UBC-Rocket/2022-2023-Avionics-HW/Radio Board/board.png

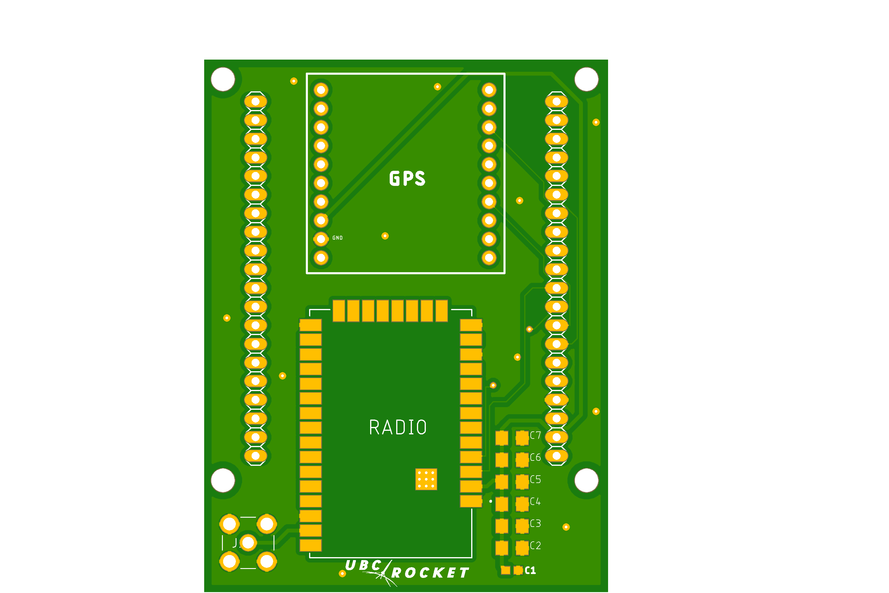
Radio Board/board.png
