UBC-Rocket/2022-2023-Avionics-HW/Ignition/Project Outputs for Avionics_Ignition/Avionics_Ignition.xlsx

Sheet: Manufacturing
 |  | Bill of Materials for |  | Avionics_Ignition.PrjPcb
 |  | Source Data From: | Avionics_Ignition.PrjPcb
 |  | Variant: | None
 |  | Report Date: | 2022-12-14 1:29 AM
 |  |  |  | Primary |  |  |  |  | Secondary
Altium Vault P/N | Designator | Description | Qty | Supplier | Supplier Part Number | Manufacturer | Manufacturer Part Number | Supplier Unit Price | Supplier | Supplier Part Number | Manufacturer | Manufacturer Part Number | Supplier Unit Price
IS2801-4 | J1, J2 | Optocoupler DC-IN 4-CH Transistor DC-OUT 16-Pin T/R | 2 | Digi-Key | IS2801-4CT-ND | Isocom | IS2801-4 | 2.2100
CMP-2000-05299-1 | J3, J4, J5 | Male Header, Pitch 2.54 mm, 1 x 2 Position, Height 9 mm, Tail Length 3.5 mm | 3 | Digi-Key | 277-1273-ND | Phoenix Contact | 1725656 | 2.7100 | Mouser | 651-1725656 | Phoenix Contact | 1725656 | 2.6300
PINHD-1X20 | JP1, JP2 | PIN HEADER | 2
WIRE_CONNECTOR | PTH1, PTH2 |  | 2
PSMN5R6-60YLX | Q1, Q2, Q3 | PSMN5R6-60YL - N-channel 60 V, 5.6 mO logic level MOSFET in LFPAK56 | 3 | Mouser | 771-PSMN5R6-60YLX | Nexperia | PSMN5R6-60YLX | 1.6300
WR06X331JTL | R1, R2, R3 | Res Thick Film 0603 330 Ohm 5% 0.1W(1/10W) ±100ppm/C SMD T/R | 3 | Digi-Key | 1292-WR06X331JTLCT-ND | Walsin Technologies | WR06X331JTL | 0.1354
CMP-1013-00510-2 | R4, R5, R9, R10, R13, R16 |  | 6 | Digi-Key | 311-1.00KCRCT-ND | Yageo | RC0805FR-071KL | 0.1354 | Digi-Key | 311-1.00KCRDKR-ND | Yageo | RC0805FR-071KL | 0.1354
CMP-1013-00102-1 | R6, R7, R8, R12, R15, R18 | 15K 0.125W 5% 0805 (2012 Metric) SMD | 6 |  |  | Rohm | MCR10EZPJ153 |  | Digi-Key | 118-CR0805-JW-153ELFCT-ND | Bourns | CR0805-JW-153ELF | 0.1354
CMP-2001-01389-1 | R11, R14, R17 |  | 3 | Digi-Key | 311-51KARCT-ND | Yageo | RC0805JR-0751KL | 0.1354 | Digi-Key | 311-51KARDKR-ND | Yageo | RC0805JR-0751KL | 0.1354

Sheet: Project Information
Project Full Path | C:\Users\trist\Desktop\Desktop\UBCEngineering\EngPhys\UBC Rocket\Avionics\2022-Avionics\Ignition\Avionics_Ignition.PrjPcb
Project Filename | Avionics_Ignition.PrjPcb
Variant Name | None
Data-Source Filename | Avionics_Ignition.PrjPcb
Data-Source Full Path | C:\Users\trist\Desktop\Desktop\UBCEngineering\EngPhys\UBC Rocket\Avionics\2022-Avionics\Ignition\Avionics_Ignition.PrjPcb
Title | Bill of Materials for Project [Avionics_Ignition.PrjPcb] (No PCB Document Selected)
Total Quantity | 30
Report Time | 1:29 AM
Report Date | 2022-12-14
Report Date & Tine | 2022-12-14 1:29 AM
Output Name | Bill of Materials
Output Type | BomReport
Output Generator Name | BOM
Output Generator Description | Bill of Materials
