UBC-Rocket/2022-2023-Avionics-HW/(list of files, drawings)

Other design files:
Ignition/Avionics_Ignition.PrjPcb
Ignition/Avionics_lib.PcbLib
Ignition/Avionics_lib.SchLib
Ignition/ignition.PcbDoc
Ignition/IgnitionPCB2.PcbDoc
Ignition/IgnitionSchem2.SchDoc
Ignition/IgnitionSchem.SchDoc
Ignition/PcbLib1.PcbLib
Ignition/schematic.PrjPcb
NewMCU/MCU.SchDoc
NewMCU/MCU_Footprints.PcbLib
NewMCU/MCU_Symbols.SchLib
NewMCU/microSD.SchDoc
NewMCU/NewMCU.PrjPcb
NewMCU/schematic.PcbDoc
NewMCU/schematic.SchDoc
