UBC-Rocket/2022-2023-Avionics-HW/Backup MCU/schematic.brd

## EAGLE design Backup MCU/schematic.brd (2023-04-22)

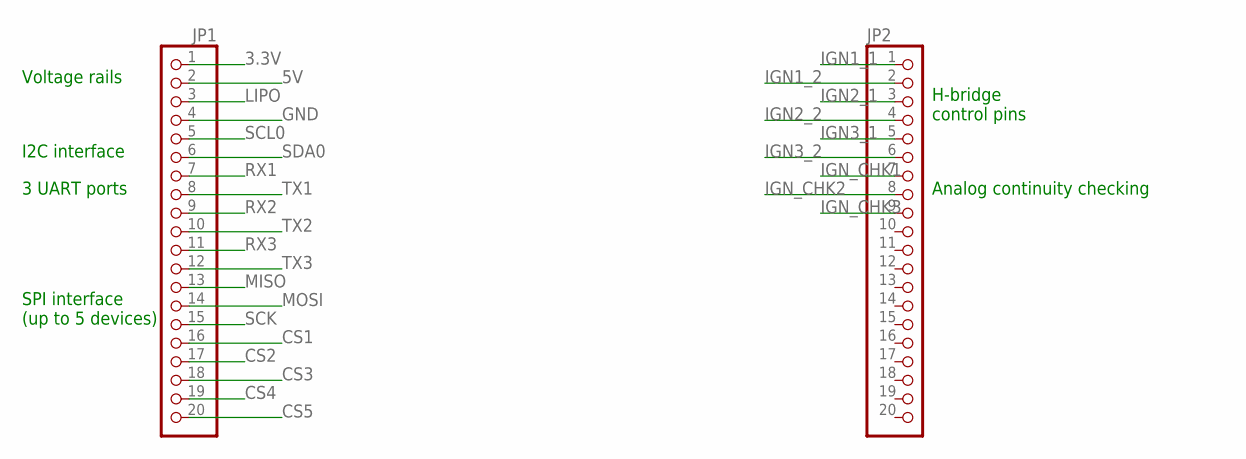
[picture p2: schematic schematic.sch, sheet 1]

Parts:
JP1, JP2: PINHD-1X20; 1X20

Connections:
3.3V: JP1.1; also elsewhere on the board
5V: JP1.2
CS1: JP1.16
CS2: JP1.17
CS3: JP1.18
CS4: JP1.19
CS5: JP1.20
GND: JP1.4; also elsewhere on the board
IGN1_1: JP2.1; also elsewhere on the board
IGN1_2: JP2.2; also elsewhere on the board
IGN2_1: JP2.3; also elsewhere on the board
IGN2_2: JP2.4; also elsewhere on the board
IGN3_1: JP2.5; also elsewhere on the board
IGN3_2: JP2.6; also elsewhere on the board
IGN_CHK1: JP2.7; also elsewhere on the board
IGN_CHK2: JP2.8; also elsewhere on the board
IGN_CHK3: JP2.9; also elsewhere on the board
LIPO: JP1.3; also elsewhere on the board
MISO: JP1.13
MOSI: JP1.14
RX1: JP1.7; also elsewhere on the board
RX2: JP1.9; also elsewhere on the board
RX3: JP1.11
SCK: JP1.15
SCL0: JP1.5; also elsewhere on the board
SDA0: JP1.6; also elsewhere on the board
TX1: JP1.8; also elsewhere on the board
TX2: JP1.10; also elsewhere on the board
TX3: JP1.12

Notes on the sheet:
SPI interface (up to 5 devices)
3 UART ports
I2C interface
Voltage rails
H-bridge control pins
Analog continuity checking

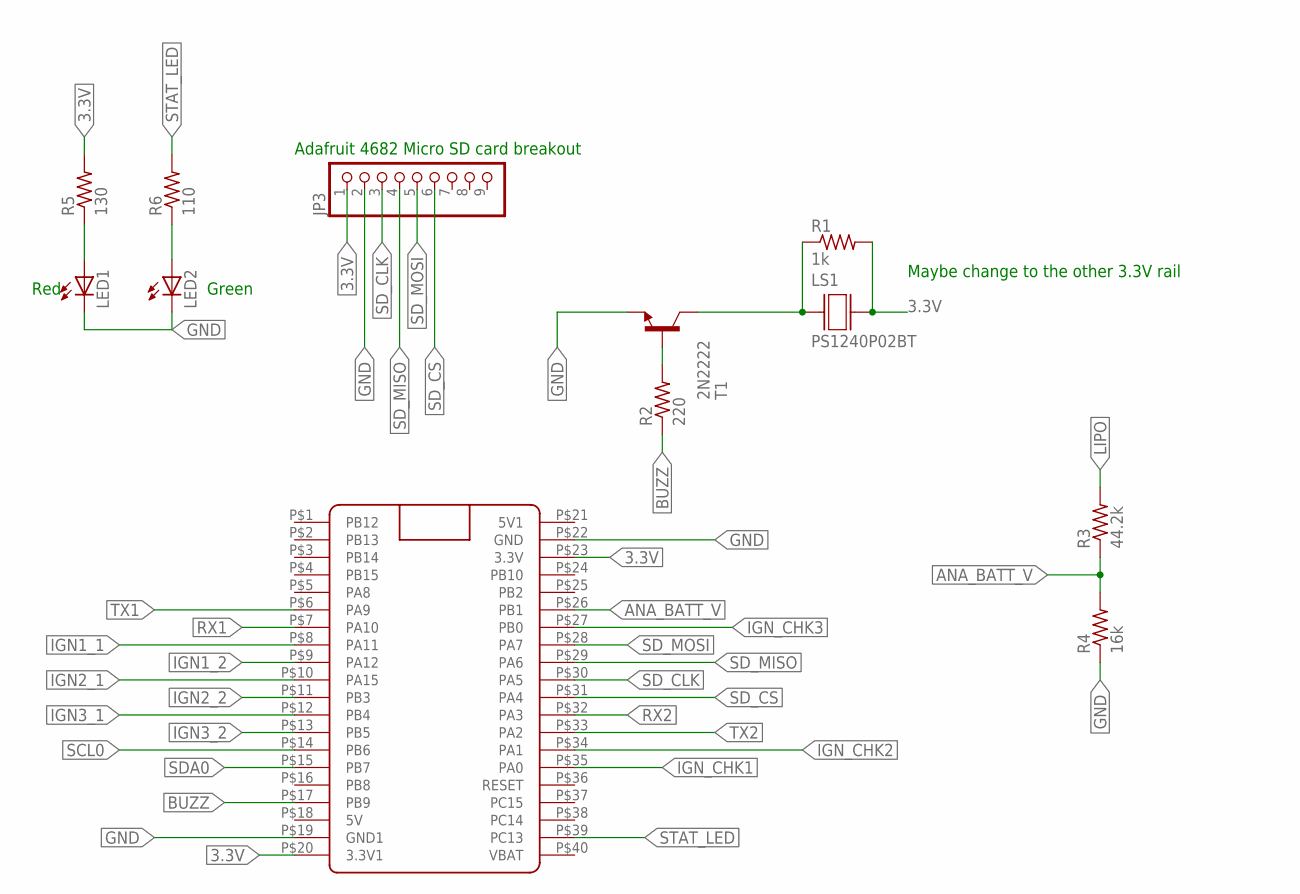
[picture p3: schematic schematic.sch, sheet 2]

Parts:
JP3: PINHD-1X9; 1X09-BIG
LED1, LED2: LED5MM
LS1: PS1240P02BT; XDCR_PS1240P02BT
R1: 1k; 0204/7
R2: 220; 0204/7
R3: 44.2k; 0204/7
R4: 16k; 0204/7
R5: 130; 0204/7
R6: 110; 0204/7
T1: 2N2222; TO92-EBC-OVAL
U$1: BLACK_PILL

Connections:
3.3V: JP3.1, LS1.2, R1.2, R5.2, U$1.P$20 (3.3V1), U$1.P$23 (3.3V); also elsewhere on the board
ANA_BATT_V: R3.1, R4.2, U$1.P$26 (PB1)
BUZZ: R2.1, U$1.P$17 (PB9)
GND: JP3.2, LED1.K (C), LED2.K (C), R4.1, T1.E, U$1.P$19 (GND1), U$1.P$22 (GND); also elsewhere on the board
IGN1_1: U$1.P$8 (PA11); also elsewhere on the board
IGN1_2: U$1.P$9 (PA12); also elsewhere on the board
IGN2_1: U$1.P$10 (PA15); also elsewhere on the board
IGN2_2: U$1.P$11 (PB3); also elsewhere on the board
IGN3_1: U$1.P$12 (PB4); also elsewhere on the board
IGN3_2: U$1.P$13 (PB5); also elsewhere on the board
IGN_CHK1: U$1.P$35 (PA0); also elsewhere on the board
IGN_CHK2: U$1.P$34 (PA1); also elsewhere on the board
IGN_CHK3: U$1.P$27 (PB0); also elsewhere on the board
LIPO: R3.2; also elsewhere on the board
unnamed: LS1.1, R1.1, T1.C
unnamed: LED1.A, R5.1
unnamed: R2.2, T1.B
unnamed: LED2.A, R6.1
RX1: U$1.P$7 (PA10); also elsewhere on the board
RX2: U$1.P$32 (PA3); also elsewhere on the board
SCL0: U$1.P$14 (PB6); also elsewhere on the board
SDA0: U$1.P$15 (PB7); also elsewhere on the board
SD_CLK: JP3.3, U$1.P$30 (PA5)
SD_CS: JP3.6, U$1.P$31 (PA4)
SD_MISO: JP3.4, U$1.P$29 (PA6)
SD_MOSI: JP3.5, U$1.P$28 (PA7)
STAT_LED: R6.2, U$1.P$39 (PC13)
TX1: U$1.P$6 (PA9); also elsewhere on the board
TX2: U$1.P$33 (PA2); also elsewhere on the board

Notes on the sheet:
Adafruit 4682 Micro SD card breakout
Maybe change to the other 3.3V rail
Green
Red

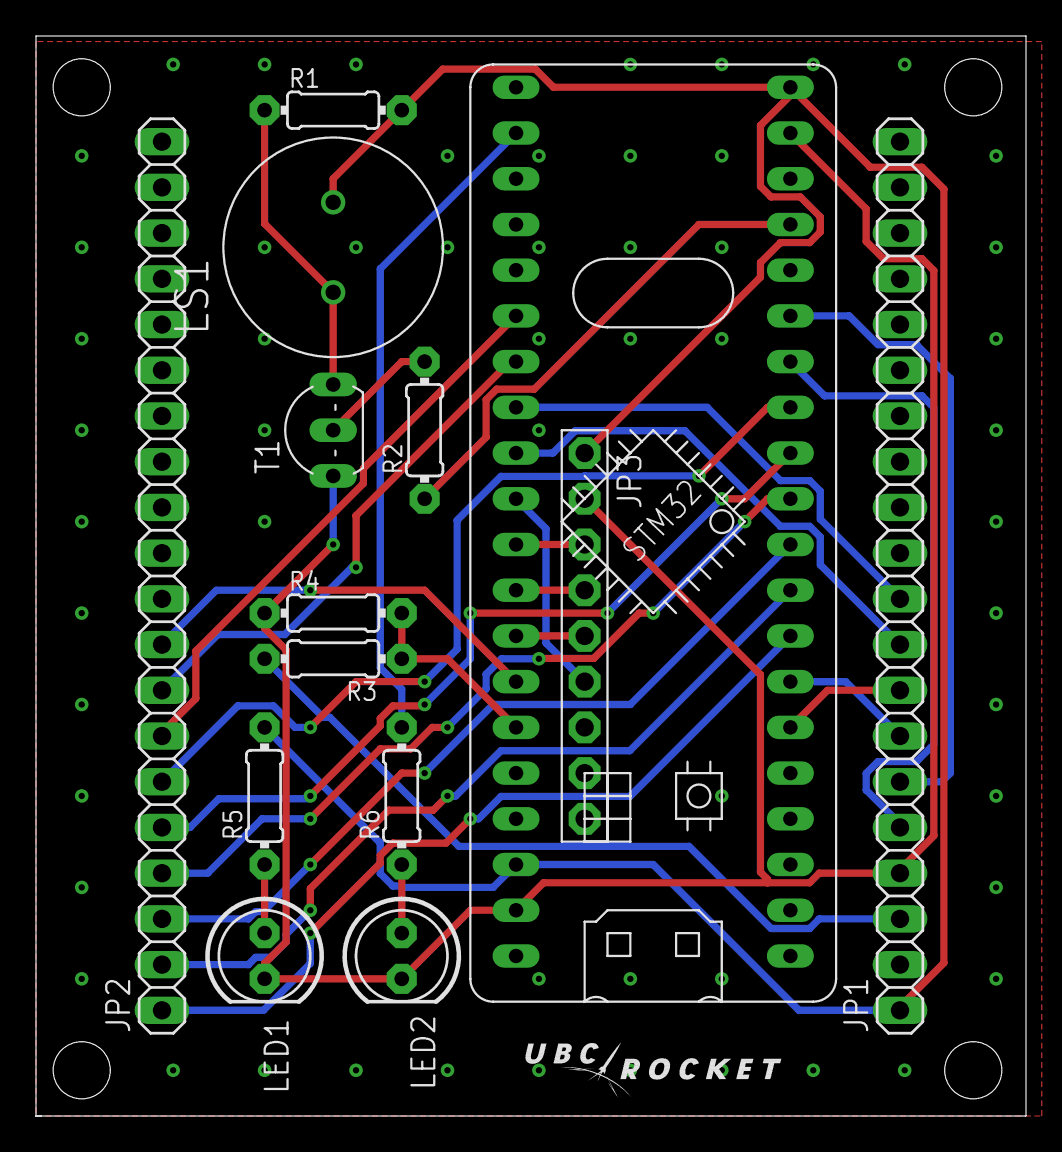
[picture p4: board Backup MCU/schematic.brd from above]

Board: 2 copper layers, 55.0 x 60.0 mm, 14 parts (0 on the bottom side), 29 nets.
