UBC-Rocket/2022-2023-Avionics-HW/STM32L433 MCU board/schematic.brd

## EAGLE design STM32L433 MCU board/schematic.brd (2023-03-19, an earlier design)

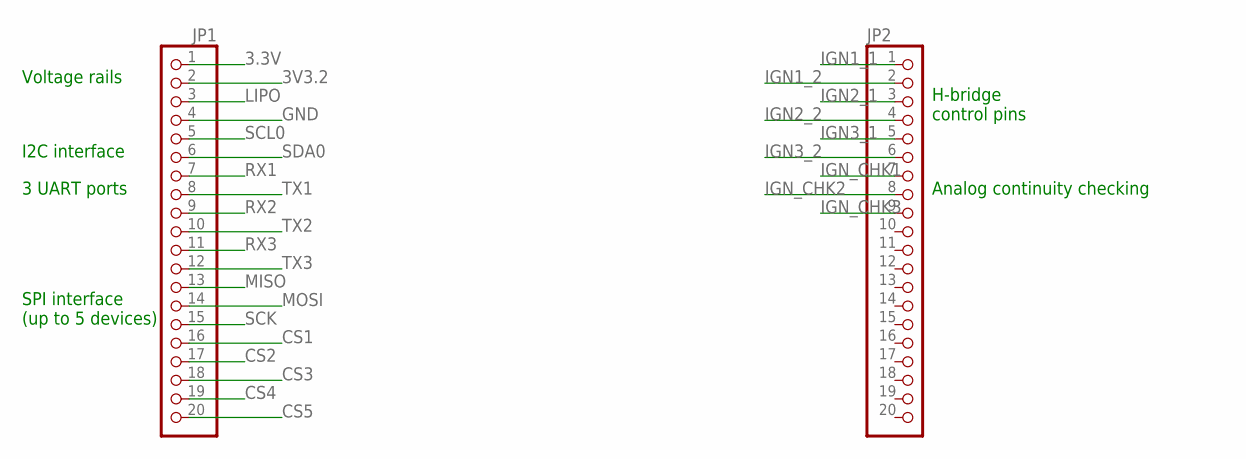
[picture p5: schematic schematic.sch, sheet 1]

Parts:
JP1, JP2: PINHD-1X20; 1X20

Connections:
3.3V: JP1.1; also elsewhere on the board
3V3.2: JP1.2
CS1: JP1.16; also elsewhere on the board
CS2: JP1.17; also elsewhere on the board
CS3: JP1.18; also elsewhere on the board
CS4: JP1.19; also elsewhere on the board
CS5: JP1.20; also elsewhere on the board
GND: JP1.4; also elsewhere on the board
IGN1_1: JP2.1; also elsewhere on the board
IGN1_2: JP2.2; also elsewhere on the board
IGN2_1: JP2.3; also elsewhere on the board
IGN2_2: JP2.4; also elsewhere on the board
IGN3_1: JP2.5; also elsewhere on the board
IGN3_2: JP2.6; also elsewhere on the board
IGN_CHK1: JP2.7; also elsewhere on the board
IGN_CHK2: JP2.8; also elsewhere on the board
IGN_CHK3: JP2.9; also elsewhere on the board
LIPO: JP1.3; also elsewhere on the board
MISO: JP1.13; also elsewhere on the board
MOSI: JP1.14; also elsewhere on the board
RX1: JP1.7; also elsewhere on the board
RX2: JP1.9; also elsewhere on the board
RX3: JP1.11; also elsewhere on the board
SCK: JP1.15; also elsewhere on the board
SCL0: JP1.5; also elsewhere on the board
SDA0: JP1.6; also elsewhere on the board
TX1: JP1.8; also elsewhere on the board
TX2: JP1.10; also elsewhere on the board
TX3: JP1.12; also elsewhere on the board

Notes on the sheet:
SPI interface (up to 5 devices)
3 UART ports
I2C interface
Voltage rails
H-bridge control pins
Analog continuity checking

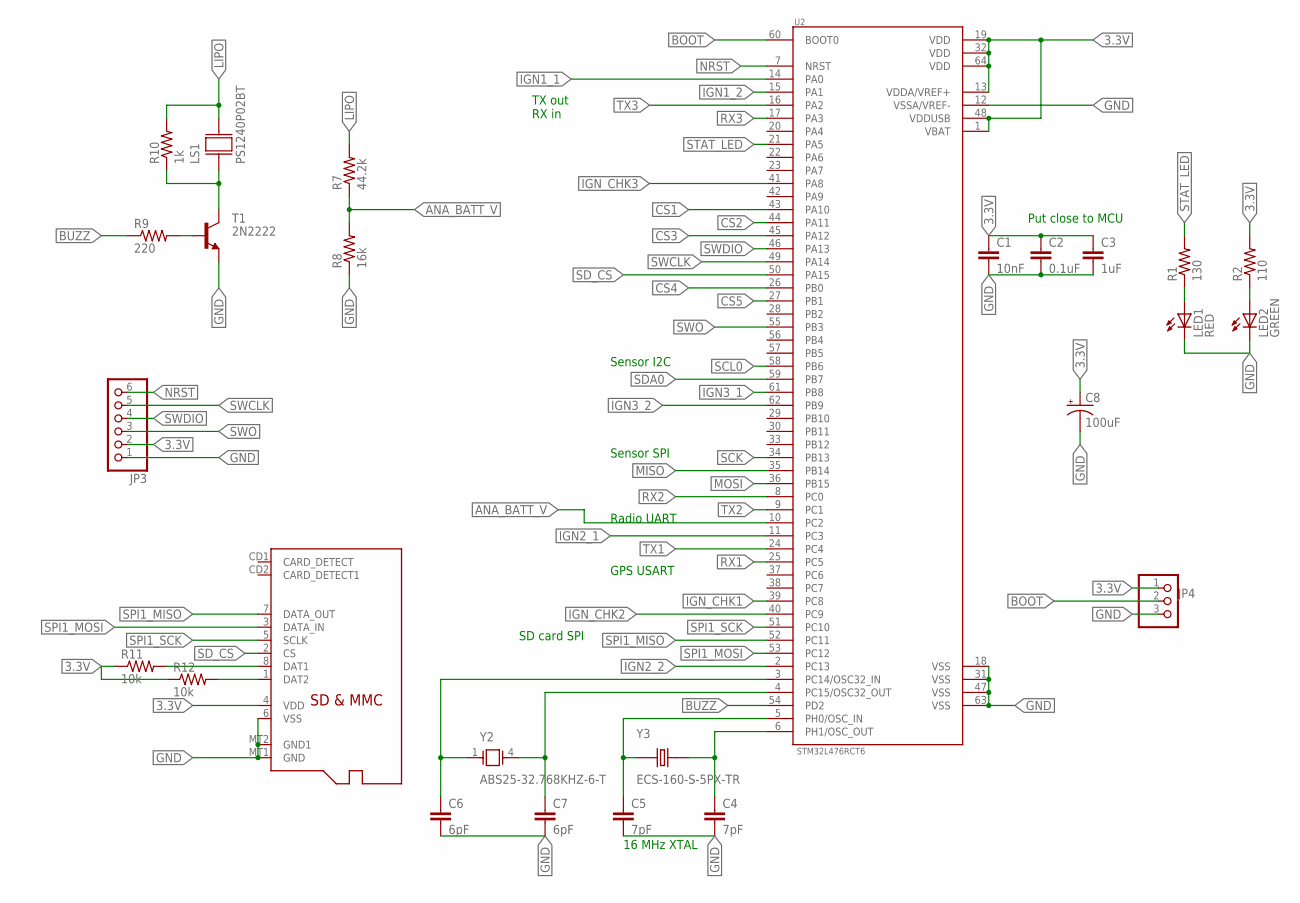
[picture p6: schematic schematic.sch, sheet 2]

Parts:
C1: 10nF; C0805
C2: 0.1uF; C0805
C3: 1uF; C0805
C4, C5: 7pF; C0805
C6, C7: 6pF; C0805
C8: 100uF; B45181B
JP3: PINHD-1X6; 1X06
JP4: PINHD-1X3; 1X03
LED1: RED; CHIPLED_0805
LED2: GREEN; CHIPLED_0805
LS1: PS1240P02BT; XDCR_PS1240P02BT
R1: 130; R0805
R2: 110; R0805
R7: 44.2k; R0805
R8: 16k; R0805
R9: 220; R0805
R10: 1k; R0805
R11, R12: 10k; R0805
T1: 2N2222; TO92-EBC-OVAL
U2: STM32L476RCT6; QFP50P120X120X160-64N
U$1: MICROSD
Y2: ABS25-32.768KHZ-6-T; XTAL_ABS25-32.768KHZ-6-T
Y3: ECS-160-S-5PX-TR; XTAL_ECS-160-S-5PX-TR

Connections:
3.3V: C1.1, C2.1, C3.1, C8.+, JP3.2, JP4.1, R2.2, R11.1, R12.1, U2.1 (VBAT), U2.13 (VDDA/VREF+), U2.19 (VDD), U2.32 (VDD), U2.48 (VDDUSB), U2.64 (VDD), U$1.4 (VDD); also elsewhere on the board
ANA_BATT_V: R7.1, R8.2, U2.10 (PC2)
BOOT: JP4.2, U2.60 (BOOT0)
BUZZ: R9.1, U2.54 (PD2)
CS1: U2.43 (PA10); also elsewhere on the board
CS2: U2.44 (PA11); also elsewhere on the board
CS3: U2.45 (PA12); also elsewhere on the board
CS4: U2.26 (PB0); also elsewhere on the board
CS5: U2.27 (PB1); also elsewhere on the board
GND: C1.2, C2.2, C3.2, C4.2, C5.2, C6.2, C7.2, C8.-, JP3.1, JP4.3, LED1.C, LED2.C, R8.1, T1.E, U2.12 (VSSA/VREF-), U2.18 (VSS), U2.31 (VSS), U2.47 (VSS), U2.63 (VSS), U$1.6 (VSS), U$1.MT1 (GND), U$1.MT2 (GND1); also elsewhere on the board
IGN1_1: U2.14 (PA0); also elsewhere on the board
IGN1_2: U2.15 (PA1); also elsewhere on the board
IGN2_1: U2.11 (PC3); also elsewhere on the board
IGN2_2: U2.2 (PC13); also elsewhere on the board
IGN3_1: U2.61 (PB8); also elsewhere on the board
IGN3_2: U2.62 (PB9); also elsewhere on the board
IGN_CHK1: U2.39 (PC8); also elsewhere on the board
IGN_CHK2: U2.40 (PC9); also elsewhere on the board
IGN_CHK3: U2.41 (PA8); also elsewhere on the board
LIPO: LS1.2, R7.2, R10.2; also elsewhere on the board
MISO: U2.35 (PB14); also elsewhere on the board
MOSI: U2.36 (PB15); also elsewhere on the board
unnamed: C5.1, U2.5 (PH0/OSC_IN), Y3.1
unnamed: R9.2, T1.B
unnamed: LS1.1, R10.1, T1.C
unnamed: R11.2, U$1.8 (DAT1)
unnamed: C4.1, U2.6 (PH1/OSC_OUT), Y3.2
unnamed: R12.2, U$1.1 (DAT2)
unnamed: LED1.A, R1.1
unnamed: LED2.A, R2.1
unnamed: C7.1, U2.4 (PC15/OSC32_OUT), Y2.4
unnamed: C6.1, U2.3 (PC14/OSC32_IN), Y2.1
NRST: JP3.6, U2.7 (NRST)
RX1: U2.25 (PC5); also elsewhere on the board
RX2: U2.8 (PC0); also elsewhere on the board
RX3: U2.17 (PA3); also elsewhere on the board
SCK: U2.34 (PB13); also elsewhere on the board
SCL0: U2.58 (PB6); also elsewhere on the board
SDA0: U2.59 (PB7); also elsewhere on the board
SD_CS: U2.50 (PA15), U$1.2 (CS)
SPI1_MISO: U2.52 (PC11), U$1.7 (DATA_OUT)
SPI1_MOSI: U2.53 (PC12), U$1.3 (DATA_IN)
SPI1_SCK: U2.51 (PC10), U$1.5 (SCLK)
STAT_LED: R1.2, U2.21 (PA5)
SWCLK: JP3.5, U2.49 (PA14)
SWDIO: JP3.4, U2.46 (PA13)
SWO: JP3.3, U2.55 (PB3)
TX1: U2.24 (PC4); also elsewhere on the board
TX2: U2.9 (PC1); also elsewhere on the board
TX3: U2.16 (PA2); also elsewhere on the board

Notes on the sheet:
Sensor SPI
Sensor I2C
SD card SPI
Put close to MCU
Radio UART
GPS USART
TX out RX in
16 MHz XTAL

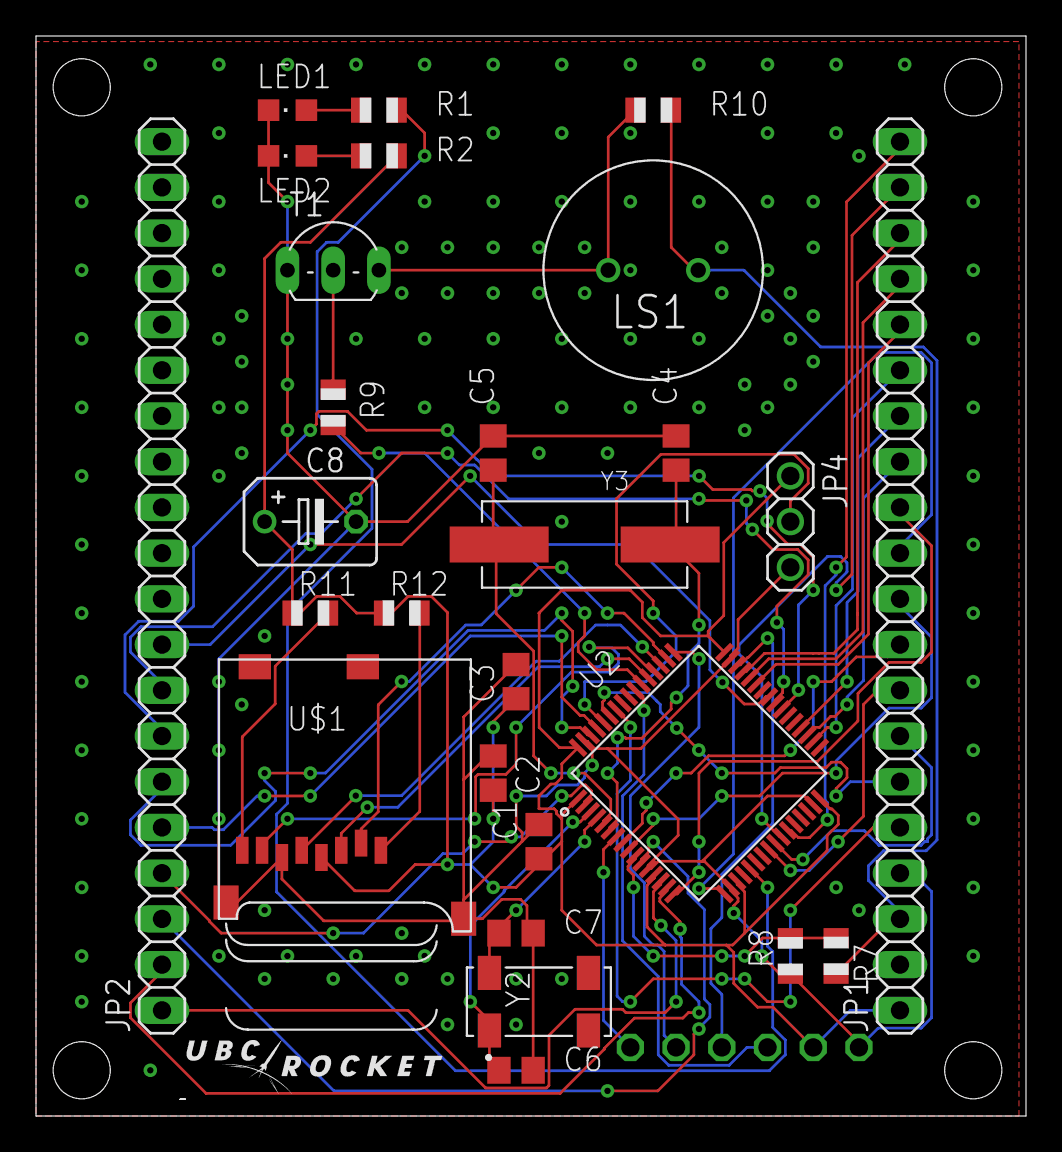
[picture p7: board STM32L433 MCU board/schematic.brd from above]

Board: 2 copper layers, 55.0 x 60.0 mm, 28 parts (1 on the bottom side), 50 nets.
