UBC-Rocket/2022-2023-Avionics-HW/Power/schematic.brd

## EAGLE design Power/schematic.brd (2023-03-19)

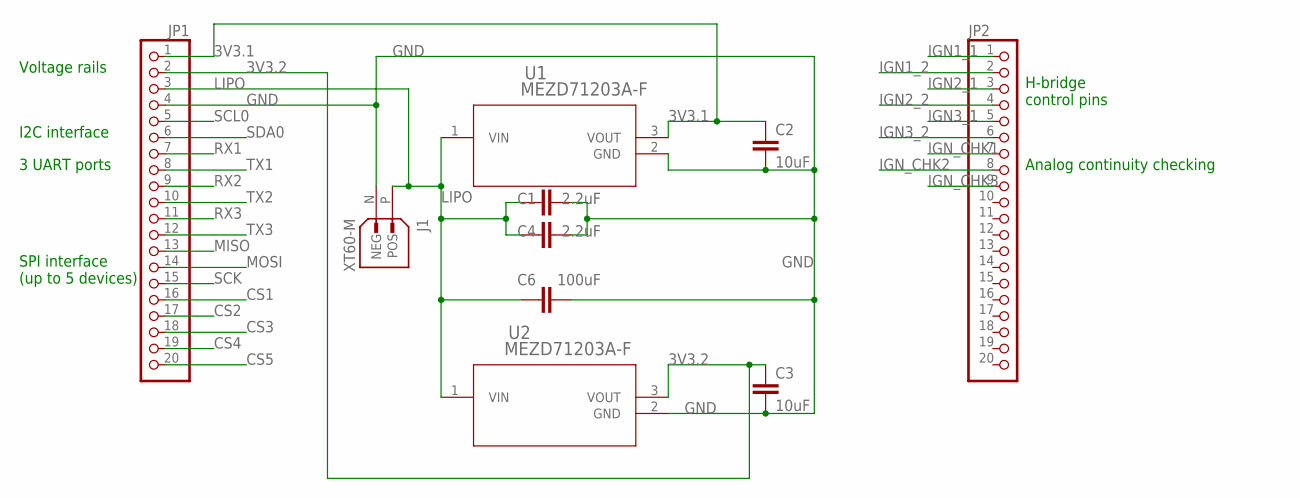
[picture p8: schematic schematic.sch]

Parts:
C1, C4: 2.2uF; C0805
C2, C3: 10uF; C0805
C6: 100uF; C0805
J1: XT60-M; AMASS_XT60-M
JP1, JP2: PINHD-1X20; 1X20
U1, U2: MEZD71203A-F; MEZD71203A_MNP

Connections:
3V3.1: C2.1, JP1.1, U1.3 (VOUT)
3V3.2: C3.1, JP1.2, U2.3 (VOUT)
CS1: JP1.16
CS2: JP1.17
CS3: JP1.18
CS4: JP1.19
CS5: JP1.20
GND: C1.2, C2.2, C3.2, C4.2, C6.2, J1.N (NEG), JP1.4, U1.2 (GND), U2.2 (GND)
IGN1_1: JP2.1
IGN1_2: JP2.2
IGN2_1: JP2.3
IGN2_2: JP2.4
IGN3_1: JP2.5
IGN3_2: JP2.6
IGN_CHK1: JP2.7
IGN_CHK2: JP2.8
IGN_CHK3: JP2.9
LIPO: C1.1, C4.1, C6.1, J1.P (POS), JP1.3, U1.1 (VIN), U2.1 (VIN)
MISO: JP1.13
MOSI: JP1.14
RX1: JP1.7
RX2: JP1.9
RX3: JP1.11
SCK: JP1.15
SCL0: JP1.5
SDA0: JP1.6
TX1: JP1.8
TX2: JP1.10
TX3: JP1.12

Notes on the sheet:
SPI interface (up to 5 devices)
3 UART ports
I2C interface
Voltage rails
H-bridge control pins
Analog continuity checking

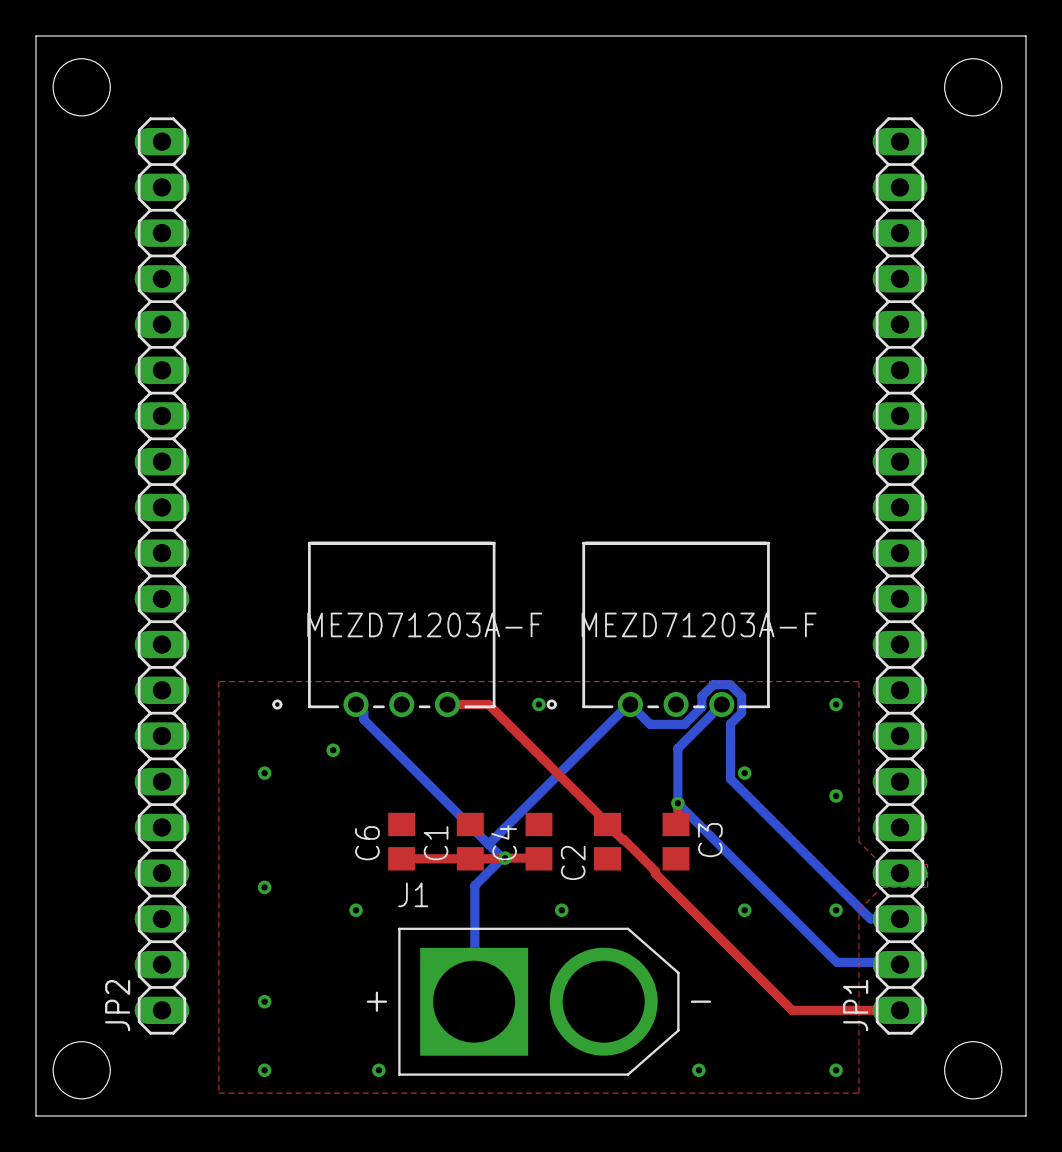
[picture p9: board Power/schematic.brd from above]

Board: 2 copper layers, 55.0 x 60.0 mm, 10 parts (0 on the bottom side), 4 nets.
