UBC-Rocket/2022-2023-Avionics-HW/Radio Board/schematic.brd

## EAGLE design Radio Board/schematic.brd (2023-03-19)

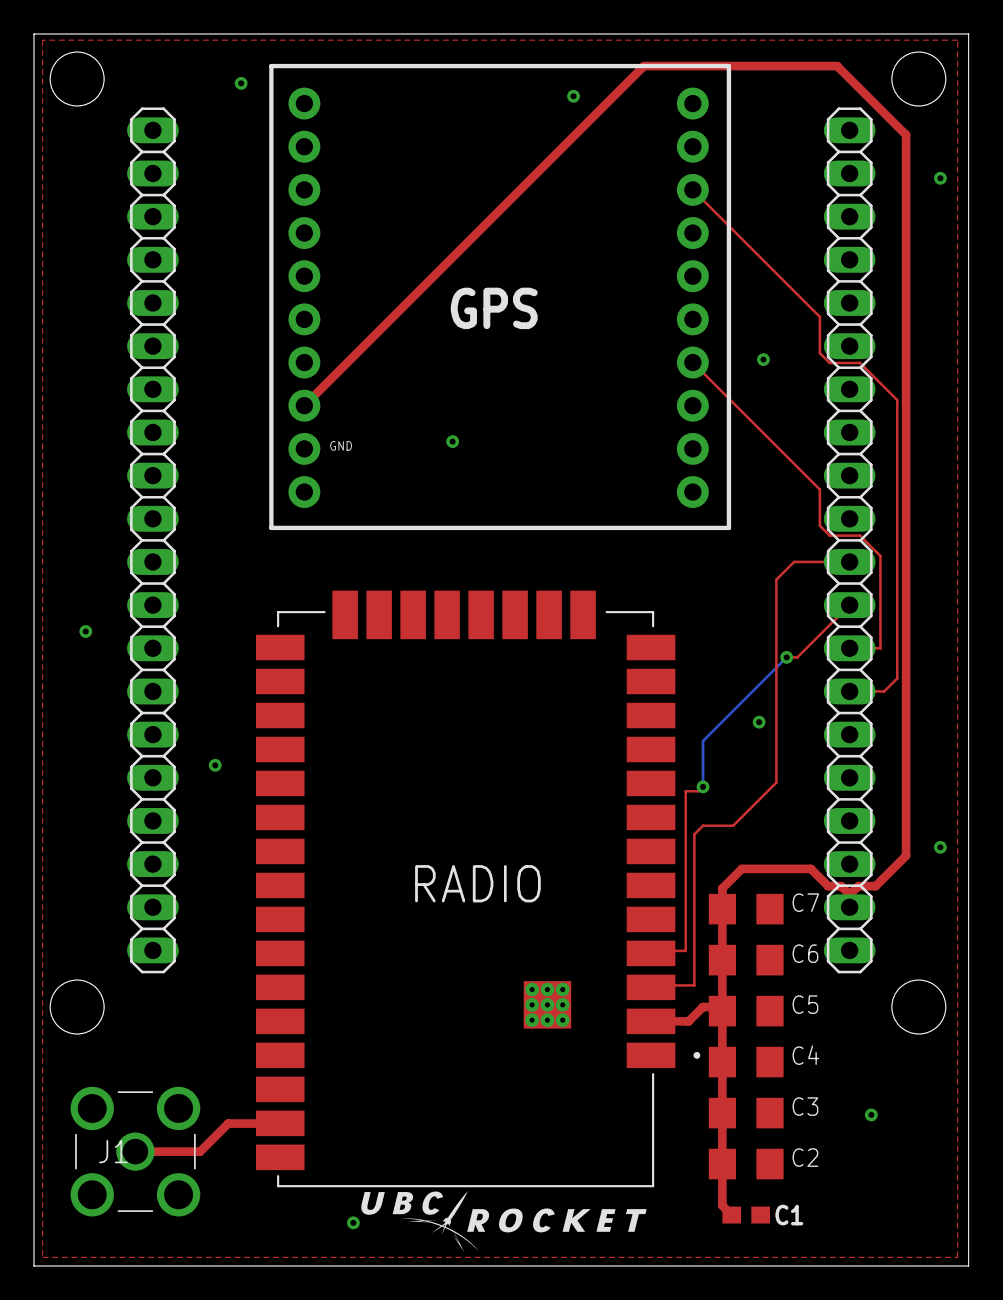
[picture p10: board Radio Board/schematic.brd from above]

Board: 2 copper layers, 55.0 x 72.5 mm, 13 parts (0 on the bottom side), 7 nets.

Parts:
C1: 100pF; 0603
C2, C3: 1uF; 1206
C4, C5: 47uF; 1206
C6, C7: 100uF; 1206
GPS: 1X10_NO_SILK
J1: 132134RP
J3: 1X10_NO_SILK
JP1, JP2: 1X20
RADIO: XBP9X-DMRS-001; MODULE_XBP9X-DMRS-001

Connections:
3V3.2: C1.1, C2.1, C3.1, C4.1, C5.1, C6.1, C7.1, J3.8, JP1.2, RADIO.2
GND: C1.2, C2.2, C3.2, C4.2, C5.2, C6.2, C7.2, J1.2, J1.3, J1.4, J1.5, J3.9, JP1.4, RADIO.1, RADIO.11, RADIO.13, RADIO.22, RADIO.35, RADIO.38, RADIO.V38_1, RADIO.V38_2, RADIO.V38_3, RADIO.V38_4, RADIO.V38_5, RADIO.V38_6, RADIO.V38_7, RADIO.V38_8, RADIO.V38_9
RF: J1.1, RADIO.36
RX1: GPS.3, JP1.7
RX2: JP1.9, RADIO.4
TX1: GPS.7, JP1.8
TX2: JP1.10, RADIO.3
