UBC-Rocket/2022-2023-Avionics-HW/Sensors/schematic.brd

## EAGLE design Sensors/schematic.brd (2022-12-25, an earlier design)

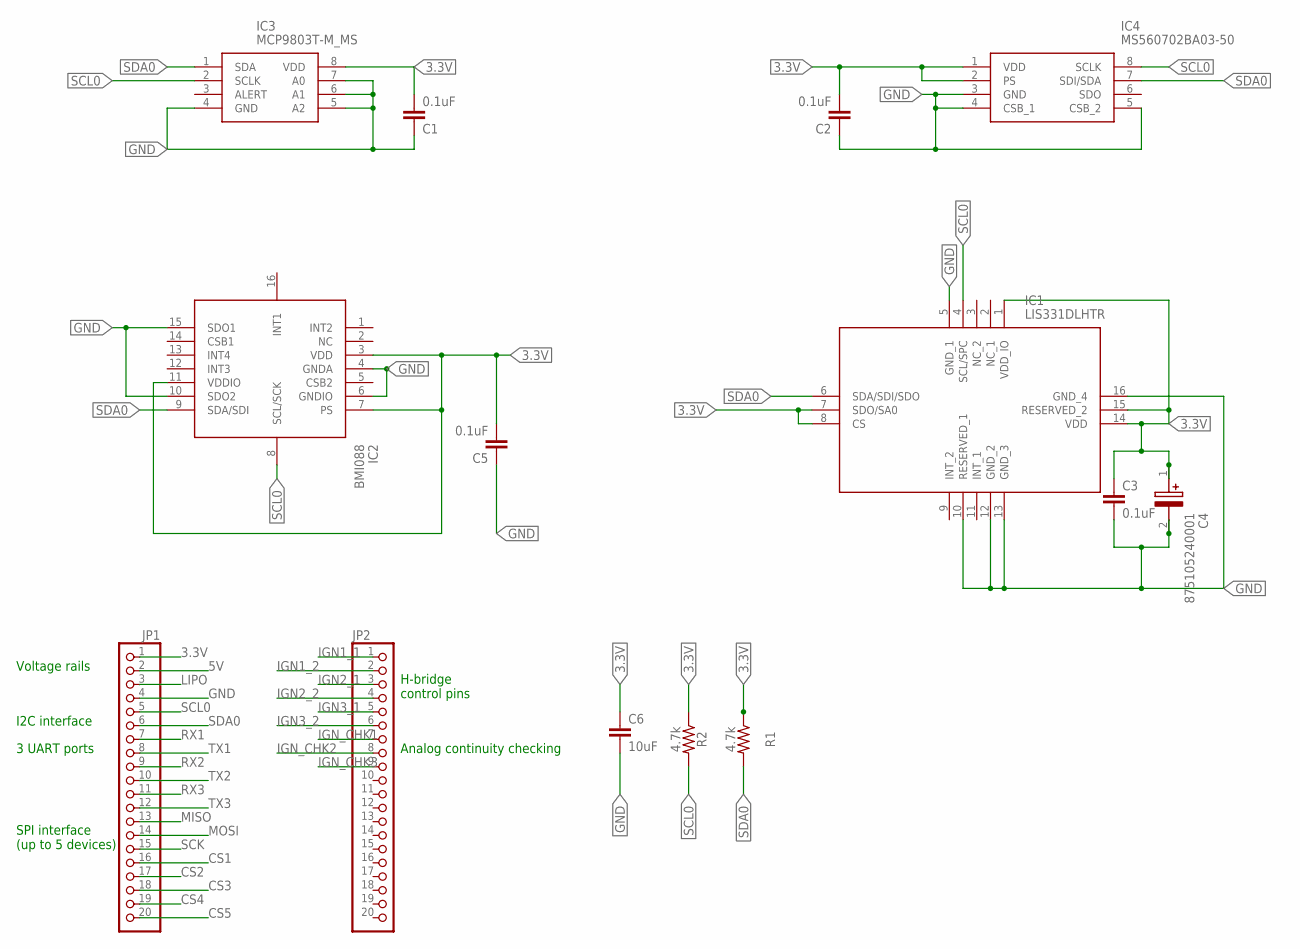
[picture p11: schematic schematic.sch]

Parts:
C1, C2, C3, C5: 0.1uF; 0805
C4: 875105240001; CAPAE430X550N
C6: 10uF; 0805
IC1: LIS331DLHTR
IC2: BMI088
IC3: MCP9803T-M_MS; SOP65P490X110-8N
IC4: MS560702BA03-50; MS5607-02BA03
JP1, JP2: PINHD-1X20; 1X20
R1, R2: 4.7k; 0805

Connections:
3.3V: C1.2, C2.2, C3.2, C4.1 (+), C5.2, C6.1, IC1.1 (VDD_IO), IC1.7 (SDO/SA0), IC1.8 (CS), IC1.14 (VDD), IC1.15 (RESERVED_2), IC2.3 (VDD), IC2.7 (PS), IC2.11 (VDDIO), IC3.8 (VDD), IC4.1 (VDD), IC4.2 (PS), JP1.1, R1.1, R2.1
5V: JP1.2
CS1: JP1.16
CS2: JP1.17
CS3: JP1.18
CS4: JP1.19
CS5: JP1.20
GND: C1.1, C2.1, C3.1, C4.2 (-), C5.1, C6.2, IC1.5 (GND_1), IC1.10 (RESERVED_1), IC1.12 (GND_2), IC1.13 (GND_3), IC1.16 (GND_4), IC2.4 (GNDA), IC2.6 (GNDIO), IC2.10 (SDO2), IC2.15 (SDO1), IC3.4 (GND), IC3.5 (A2), IC3.6 (A1), IC3.7 (A0), IC4.3 (GND), IC4.4 (CSB_1), IC4.5 (CSB_2), JP1.4
IGN1_1: JP2.1
IGN1_2: JP2.2
IGN2_1: JP2.3
IGN2_2: JP2.4
IGN3_1: JP2.5
IGN3_2: JP2.6
IGN_CHK1: JP2.7
IGN_CHK2: JP2.8
IGN_CHK3: JP2.9
LIPO: JP1.3
MISO: JP1.13
MOSI: JP1.14
RX1: JP1.7
RX2: JP1.9
RX3: JP1.11
SCK: JP1.15
SCL0: IC1.4 (SCL/SPC), IC2.8 (SCL/SCK), IC3.2 (SCLK), IC4.8 (SCLK), JP1.5, R2.2
SDA0: IC1.6 (SDA/SDI/SDO), IC2.9 (SDA/SDI), IC3.1 (SDA), IC4.7 (SDI/SDA), JP1.6, R1.2
TX1: JP1.8
TX2: JP1.10
TX3: JP1.12

Notes on the sheet:
SPI interface (up to 5 devices)
3 UART ports
I2C interface
Voltage rails
H-bridge control pins
Analog continuity checking

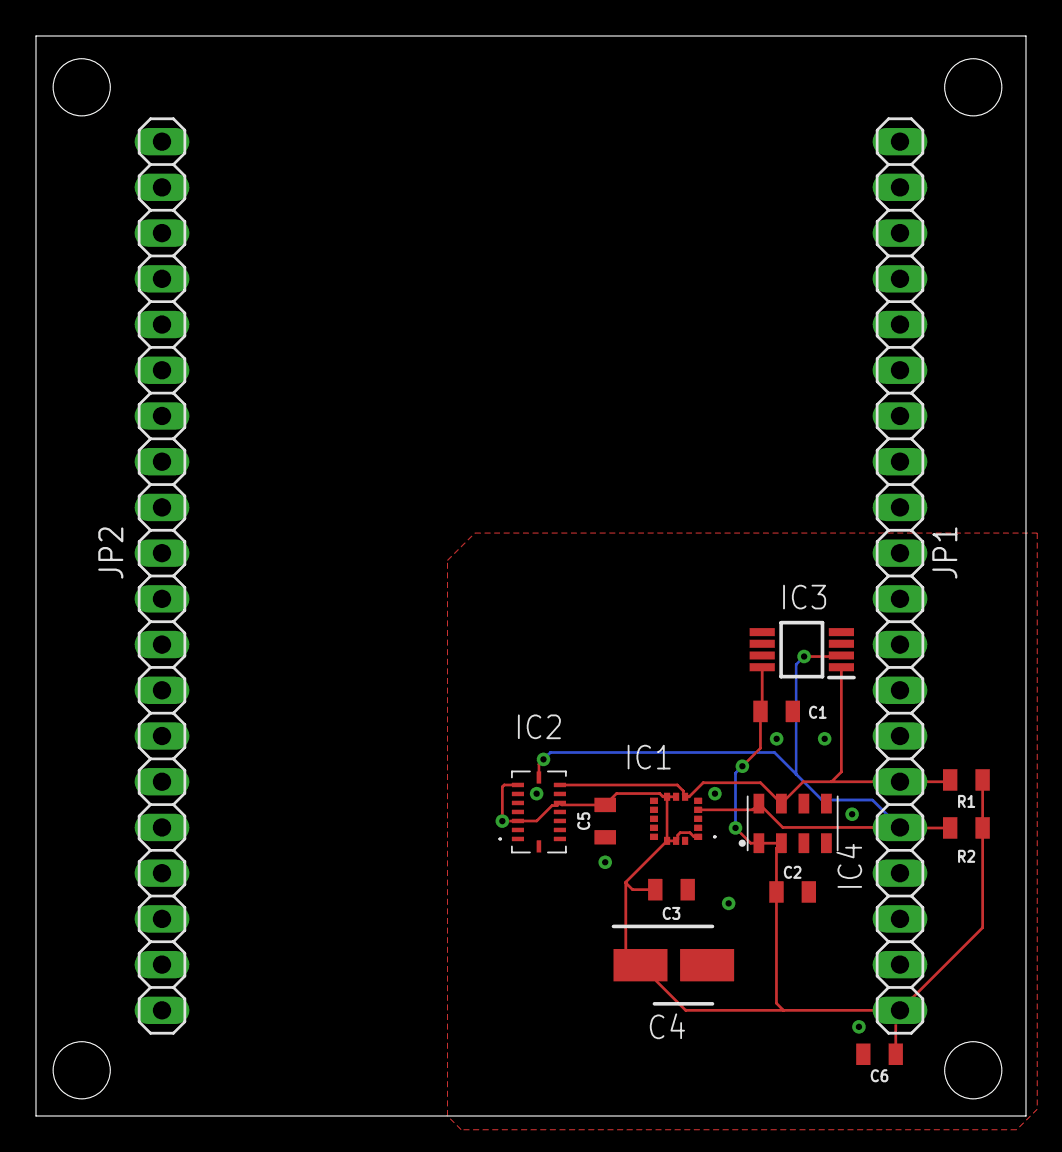
[picture p12: board Sensors/schematic.brd from above]

Board: 2 copper layers, 55.0 x 60.0 mm, 14 parts (0 on the bottom side), 4 nets.
