UBC-Rocket/2022-2023-Avionics-HW/(commit log)

2022-10-23 Copy Template for Radio Avionics
    [schematic.brd, schematic.sch]
2022-11-01 Added correct radio board
2022-11-06 Added GPS module and complementary components
    [schematic.brd, schematic.sch]
2022-11-12 created ignition folder with altium files
    [Avionics_lib.SchLib, ignition.PcbDoc, ignition.SchDoc, schematic.PrjPcb]
2022-11-12 Placing Components finished
    [schematic.brd, schematic.sch]
2022-11-12 Finished wiring
    [schematic.brd, schematic.sch]
2022-11-12 Finished Routing
    [schematic.brd, schematic.sch]
2022-11-12 fixed git ignore
    [Avionics_Ignition.PrjPcb, Avionics_lib.PcbLib, Avionics_lib.SchLib, PcbLib1.PcbLib, ignition.PcbDoc, ignition.SchDoc]
2022-11-17 created optocoupler schematic and footprint
2022-11-17 Added optoisolators to schematic, wire another igniter
    [IgnitionSchem.SchDoc]
2022-11-17 Added optoisolators to schematic, wired another igniter
    [IgnitionSchem.SchDoc]
2022-11-20 updated PCB layout, still need to add continuity checking
    [IgnitionSchem.SchDoc, ignition.PcbDoc]
2022-11-20 changed opto resistors, added new opto for last continuity check
    [Avionics_lib.PcbLib, Avionics_lib.SchLib, IgnitionSchem.SchDoc, ignition.PcbDoc]
2022-11-21 Updated radio & GPS
    [schematic.brd, schematic.sch]
2022-11-21 Finished MCU board routing
    [schematic.brd, schematic.sch]
2022-11-27 Modifying after EDR
    [IgnitionSchem.SchDoc]
2022-11-27 added a 100uF cap
    [schematic.brd, schematic.sch]
2022-11-28 Added voltage divider, changed top igniter reference, added pulldown and pullup for ingition fets, changed resitor values.
    [Avionics_Ignition.PrjPcb, Avionics_lib.PcbLib, Avionics_lib.SchLib, IgnitionSchem.SchDoc, ignition.PcbDoc]
2022-11-28 Added voltage dividers, changed resistor values, added pullup and pulldown for igniter fets, changed layout
2022-11-28 Added voltage divider, changed resistor values, added pulldown and pullup for igniter fets.
2022-11-28 did some routing
    [Avionics_Ignition.PrjPcb, IgnitionSchem.SchDoc, ignition.PcbDoc]
2022-12-01 updated radio
    [schematic.brd, schematic.sch]
2022-12-03 Radio Board - Routed traces, missing ground plane
    [schematic.brd, schematic.sch]
2022-12-03 Planes included, added backups to gitignore
    [schematic.brd]
2022-12-04 Flipped GPS Module
    [schematic.brd]
2022-12-04 moved radio silkscreen
    [schematic.brd]
2022-12-04 Added Ethan's stuff
    [schematic.brd, schematic.sch]
2022-12-05 got rid of half-bridge
    [Avionics_Ignition.PrjPcb, IgnitionSchem.SchDoc]
2022-12-24 did some autorouting, added ground plane on top layer
    [Avionics_Ignition.PrjPcb, IgnitionSchem.SchDoc, ignition.PcbDoc]
2022-12-25 Finished routing, created output files
    [Avionics_Ignition.PrjPcb, Avionics_Ignition.xls, Avionics_Ignition.xlsx, IgnitionSchem.SchDoc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]
2023-01-03 upload final power board
2023-01-06 Added NC Drill files
    [Avionics_Ignition.PrjPcb]
2023-01-15 Uploaded manufactured PCB design
    Doesn't include battery voltage wire :(
    [schematic.brd]
2023-01-22 Made some necessary changes for batch 2 :(
    That moment when you don't ground the output of oscillators and you don't connect a whole signal lol. At least we get a chance to refine the board
    [schematic.brd, schematic.sch]
2023-02-05 switched from using rxa to rxb
    [schematic.brd]
2023-02-24 Replaced oscillator components and re-ran autorouter
    Still need to route some other wires and check if pinout is good
    [schematic.brd, schematic.sch]
2023-02-25 Added gitignore
    [schematic.brd]
2023-03-04 Finished routing and ground plane stitching
    [schematic.brd, schematic.sch]
2023-03-04 Added logo
    [schematic.brd]
2023-03-06 fixed wiring on radio board
    [schematic.brd, schematic.sch]
2023-03-19 March 19th pre-edit update
    [ignition.PcbDoc]
2023-03-19 removed opto on continuity checking, and made lipo holes larger
    [Avionics_lib.PcbLib, IgnitionSchem.SchDoc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]
2023-04-02 New board using a black pill STM32 dev board
    [schematic.brd, schematic.sch]
2023-04-22 Additional changes for backup MCU
    [schematic.brd]
2023-06-16 Started a new MCU PCB design using Altium by actually reading the app note
    [MCU.SchDoc, NewMCU.PrjPcb, schematic.PcbDoc, schematic.SchDoc]
2024-03-03 New MCU board before board order
    [Bill of Materials-NewMCU(DNPd parts).csv, MCU.SchDoc, MCU_Footprints.PcbLib, MCU_Symbols.SchLib, NewMCU.PrjPcb, Pick Place for schematic(DNPd parts).csv, microSD.SchDoc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]
