UBC-Rocket/2022-2023-Avionics-HW/(notices)

Notices in the files:
parts and their libraries:
SparkFun-Connectors: Licensing: Creative Commons ShareAlike 4.0 International - https://creativecommons.org/licenses/by-sa/4.0
My-Library: COPYRIGHT: Copyright (C) 2022 Ultra Librarian. All rights reserved.
